stric9r/Line6-FBV3-Clone/Pictures/Drilling1.jpg

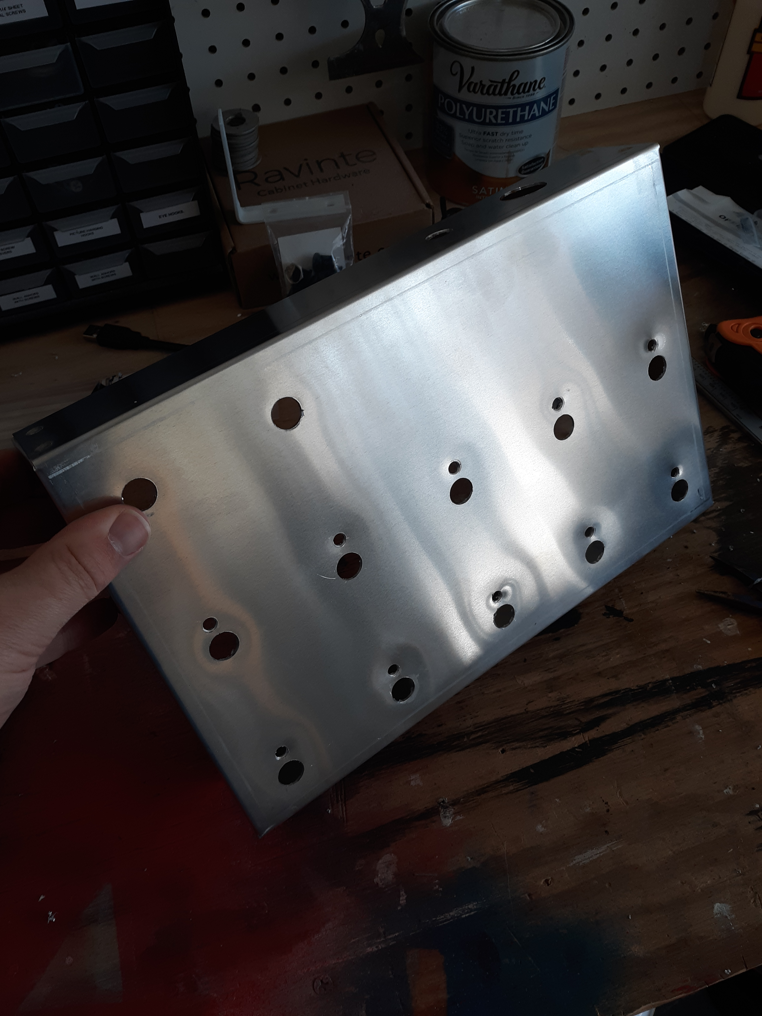
Pictures/Drilling1.jpg
