stric9r/Line6-FBV3-Clone/Pictures/Sanding.jpg

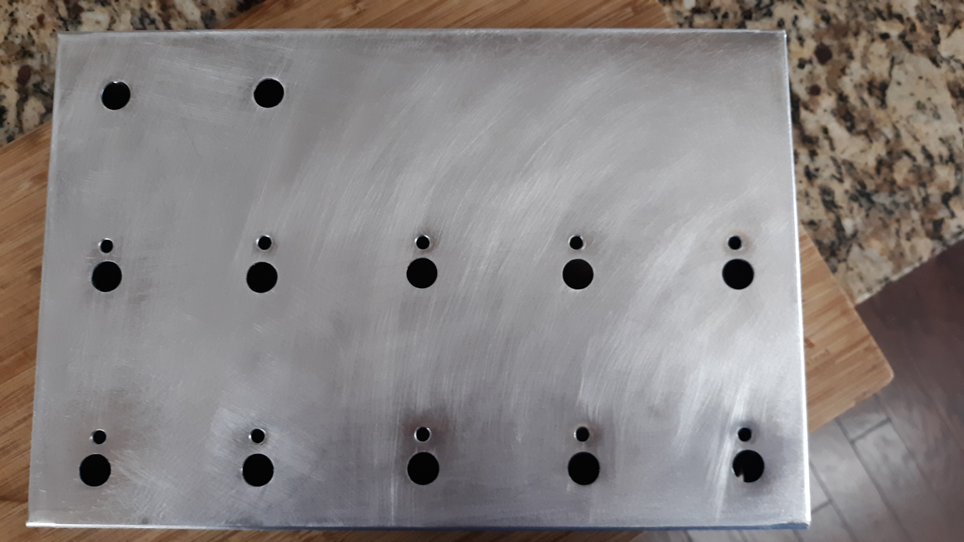
Pictures/Sanding.jpg
