stric9r/Line6-FBV3-Clone/Pictures/ArtBack.jpg

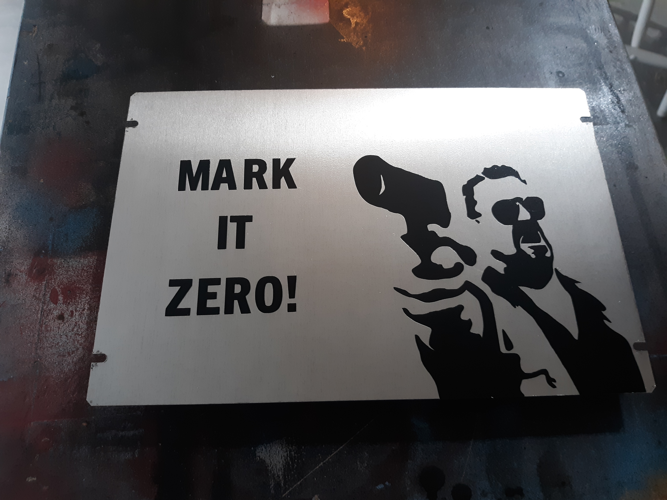
Pictures/ArtBack.jpg
