stric9r/Line6-FBV3-Clone/Pictures/ArtProfile.jpg

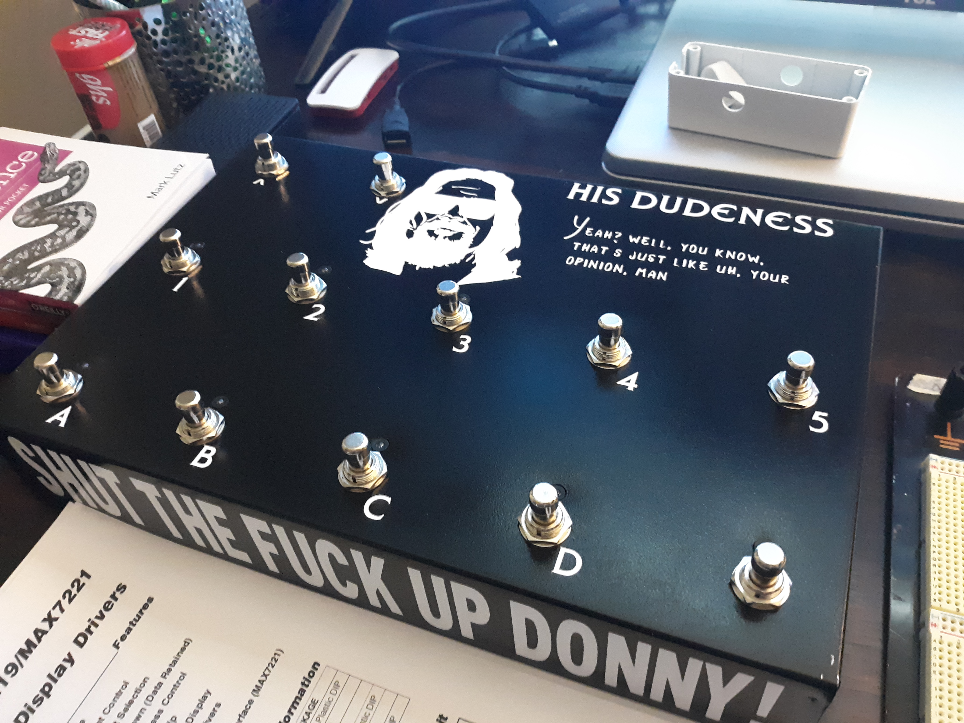
Pictures/ArtProfile.jpg
