stric9r/Line6-FBV3-Clone/Pictures/ArtTop.jpg

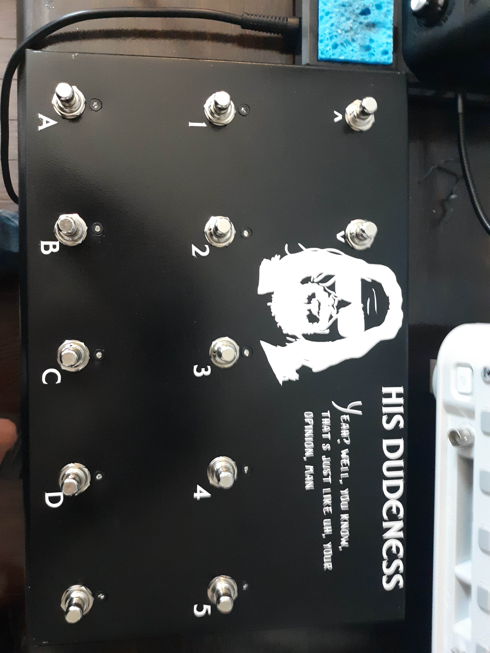
Pictures/ArtTop.jpg
