stric9r/Line6-FBV3-Clone/Pictures/Drilling2.jpg

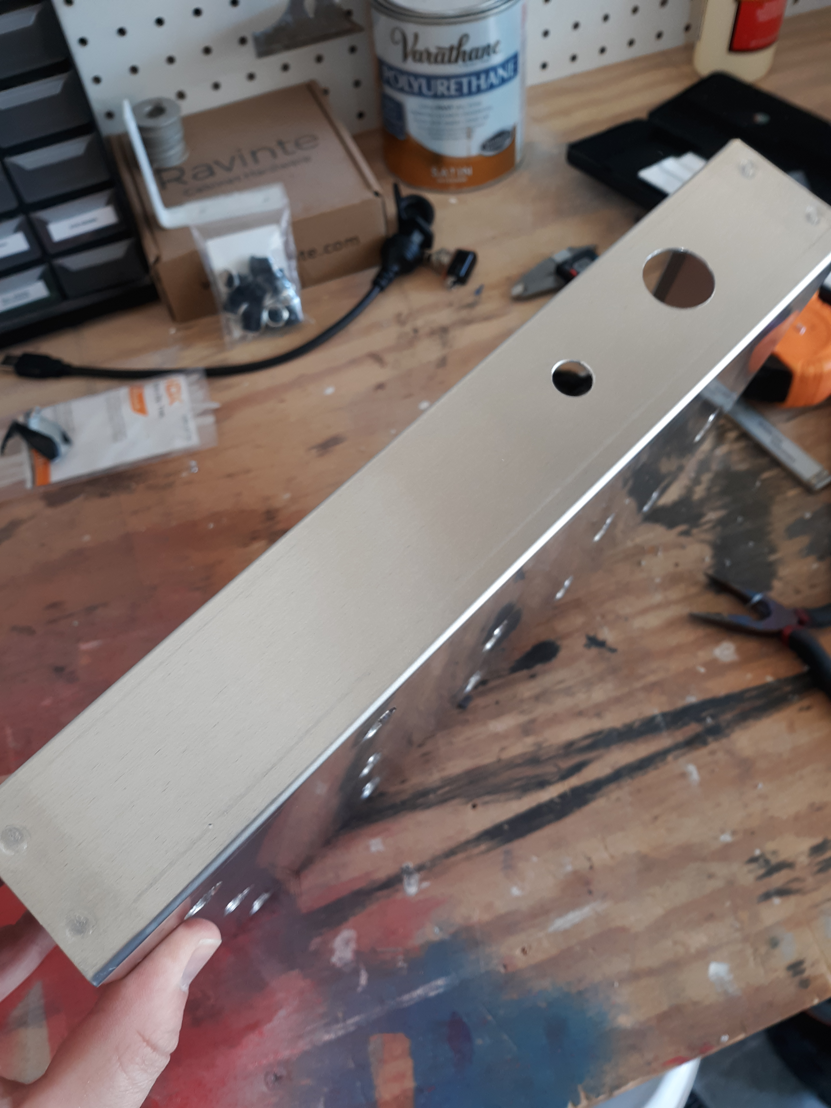
Pictures/Drilling2.jpg
