stric9r/Line6-FBV3-Clone/Pictures/Lights.jpg

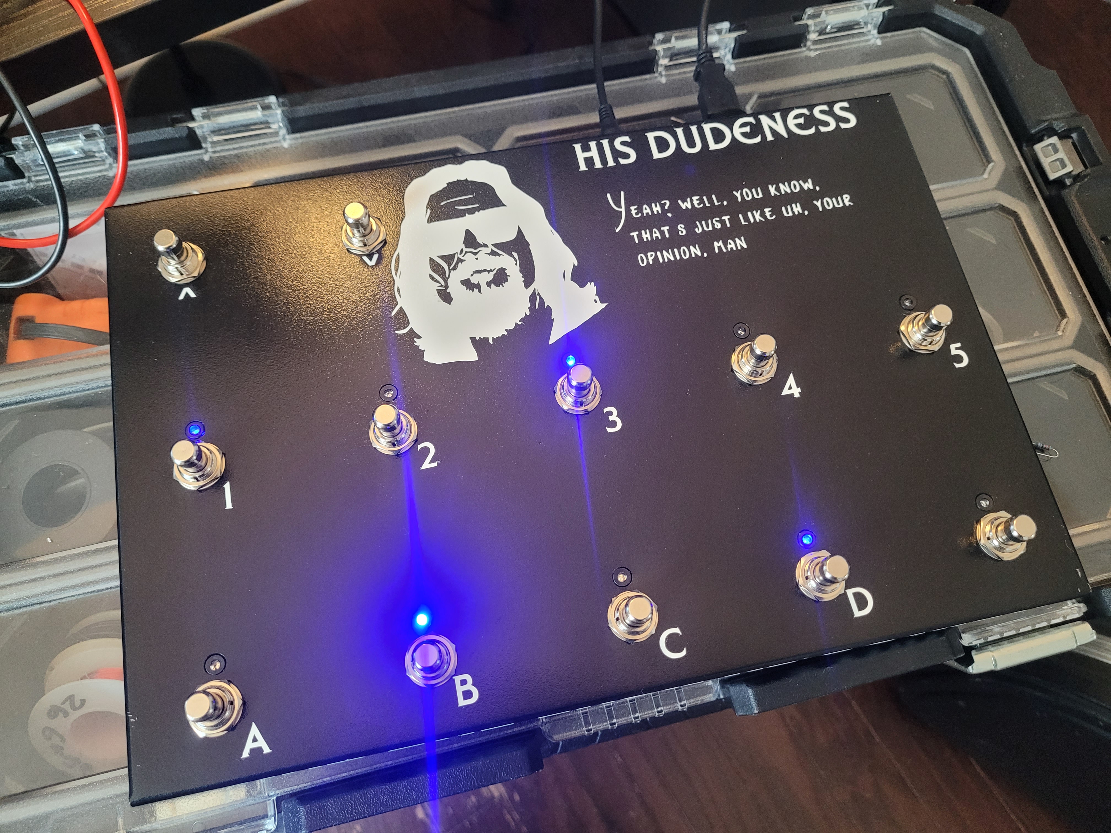
Pictures/Lights.jpg
