stric9r/Line6-FBV3-Clone/Pictures/Paint.jpg

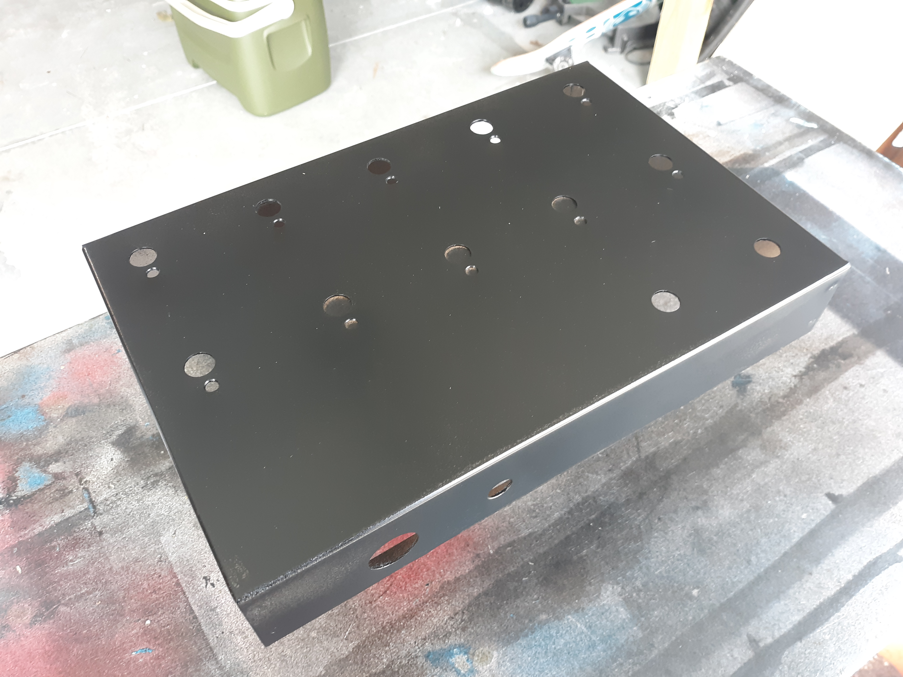
Pictures/Paint.jpg
