stric9r/Line6-FBV3-Clone/(threads)

Thread 1 (2020-12-27):

Decode feedback from amp to get effect on/off status

stric9r, 2020-12-27:

stric9r, 2020-12-27:
Once decoded add the feedback to led's that can show status of the switch

stric9r, 2021-01-09:
When switching presets, a load of data is sent, focus there first.
Also when authenticating, loads more of data is sent (overwhelming amount), look there after the pattern is found in the preset switching.

A hack would be to specify preset X when starting up, to just get the data it needs then.

stric9r, 2021-01-10:
When sending a control packet to turn on/off pedal, there are two packets returned.  Regardless of on/off, they are always the same.  Seems like this is an ACK thing:

INPUT:

0x04 0xf0 0x00 0x01
0x04 0x0c 0x22 0x00
0x04 0x4d 0x00 0x18
0x04 0x00 0x00 0x0b
0x04 0x00 0x01 0x00
0x04 0x00 0x00 0x04
0x04 0x00 0x00 0x00
0x04 0x00 0x00 0x00
0x04 0x00 0x00 0x00
0x06 0x00 0xf7 0x00
received 40
usb result code: SUCCESS

INPUT:

0x04 0xf0 0x00 0x01
0x04 0x0c 0x22 0x00
0x04 0x4d 0x00 0x19
0x04 0x00 0x01 0x07
0x04 0x00 0x03 0x00
0x04 0x00 0x00 0x10
0x04 0x00 0x00 0x03
0x04 0x00 0x02 0x00
0x04 0x00 0x00 0x7f
0x04 0x7f 0x60 0x7f
0x04 0x7f 0x02 0x00
0x04 0x00 0x00 0x01
0x04 0x00 0x00 0x00
0x04 0x00 0x00 0x00
0x07 0x00 0x00 0xf7
received 60
usb result code: SUCCESS

Thread 8 (2021-01-09):

Add on/off for Raspberry Pi

stric9r, 2021-01-09:
Add a switch or button to shut down and startup the raspberry pi properly

stric9r, 2021-03-28:
Add shutdown command based on if the TBD is held down.
Long term, Add a switch on back of HW to that shorts the run pins together to start up again.  But SW solution would be to just cycle power.

stric9r, 2021-03-31:
Just call
```
// Running Linux OS command using system
system("shutdown -P now");
```

It's a one off project, and it's not going to be ported to any OS.

Thread 9 (2021-01-10):

Improve response time

stric9r, 2021-01-10:
Right now, there seems to be a second delay for every button press.  If you press 3 buttons at the same time, each command is sent with a second delay (that's 3 seconds!).

Shorten that time frame. Look at changing timeouts first.
#define L6_TIMEOUT_OUT      2000 /// ms
#define L6_TIMEOUT_IN       250  /// ms

Right now the usb commands are implemented using simple synchronous model.  Might have to move to asynchronous model to improve response time, assuming fiddling with timeouts don't work.

Closed 2021-01-10.

Thread 15 (2021-01-12):

Implement banks

stric9r, 2021-01-12:
Right now the bank buttons only iterate through presets.  Find a way to store banks, and move through them, look at the manual for it.

stric9r, 2021-01-12:
There should be 32 banks, which is preset 1A, 2A, 3A...32A.
So bank switching just changes to preset.
There are 4 other switches that switch presets in that bank A, B, C, D.

So just use the preset command to force bank changes 0, 4, 8..all the way to max banks.
And make 4 more buttons that are labeled A,B,C,D to to increment current bank by 0, 1, 2, 3

stric9r, 2021-01-16:
Went with binary file instead of parsing strings.

Closed 2021-01-16.

Thread 23 (2021-01-24):

Make led MUX driver (CD74HC4067)

stric9r, 2021-01-24:

stric9r, 2021-01-24:
https://www.sparkfun.com/products/9056

stric9r, 2021-01-24:
No good.  After some experimenting, it looks like there is some leakage current on the un-selected pins.
Probably need to use a shift register instead.

Closed 2021-01-24.

Thread 36 (2021-12-23):

Address HW bug in MAX7219

stric9r, 2021-12-23:
Right now the current limiting resistor is 22k.  It should be closer to 10 or 14k.

This issue causes the chip to crash when too many LED's come on.
