stric9r/Line6-FBV3-Clone/Hardware/L6-FBV3-Clone/L6-FBV3-Clone.kicad_pcb

## KiCad design Q1-Keys.sch

Schematic: Q1-Keys.sch

Parts:
ND0, ND1, ND2, ND3, ND4, ND5, ND6, ND7, ND8, ND9, ND10, ND11, ND12, ND13, ND14, ND15, ND16, ND17, ND18, ND19, ND20, ND21, ND22, ND23, ND24, ND25, ND26, ND27, ND28, ND29, ND30, ND31, ND32, ND33, ND34, ND35, ND36, ND37, ND38, ND39, ND40, ND41, ND42, ND43, ND44, ND45, ND46, ND47, ND48, ND49, ND50, ND51, ND52, ND53, ND54, ND55, ND56, ND57, ND58, ND59, ND60, ND61, ND62, ND63, ND64, ND65, ND66, ND67, ND68, ND69, ND70, ND71, ND72, ND73, ND74, ND75, ND76, ND77, ND78, ND79, ND80, ND81, ND82: D
SW1, SW2, SW3, SW4, SW5, SW6, SW7, SW8, SW9, SW10, SW11, SW12, SW13, SW14, SW16, SW17, SW18, SW19, SW20, SW21, SW22, SW23, SW24, SW25, SW26, SW27, SW28, SW29, SW30, SW31, SW32, SW33, SW34, SW35, SW36, SW37, SW38, SW39, SW40, SW41, SW42, SW43, SW44, SW45, SW46, SW47, SW48, SW49, SW50, SW51, SW52, SW53, SW54, SW55, SW56, SW57, SW58, SW59, SW60, SW61, SW62, SW63, SW64, SW65, SW66, SW67, SW68, SW69, SW70, SW71, SW72, SW73, SW74, SW75, SW76, SW77, SW78, SW79, SW80, SW81, SW82: SW_Push
SW15: Rotary_Encoder_Switch
