stric9r/Line6-FBV3-Clone/Hardware/L6-FBV3-Clone/L6-FBV3-Clone.kicad_pcb

## KiCad design Q1.sch

Schematic: Q1.sch

Parts:
BOOT0: RESET
JP2: Conn_01x07_Shielded
R3, R4: R
TX: TestPoint
U6: STM32L432KBU6; QFN-32-1EP_5x5mm_P0.5mm_EP3.45x3.45mm
U7: 74HC595

Notes on the sheet:
USART1_TX
SPI1_MOSI
SPI1_NSS
