stric9r/Line6-FBV3-Clone/(commit log)

2020-12-27 Update main.c
    Fixed typo in comment
    [main.c]
2020-12-27 Added basic framework for bank changing, but still not working. Need to do more research - this is a backup.
    [main.c]
2020-12-27 Updated HELLO to be COMMAND 1
    [Line6_Spider_V_USB_Protocol.xlsx]
2021-01-09 Changed pinout of inputs to do debugging. Added string descriptions of effects for printfs.
2021-01-09 Updated documentation for bank up/down information
    [Line6_Spider_V_USB_Protocol.xlsx]
2021-01-11 Added stdint, trying to fix some build updates
    [fbv3.c, fbv3.h, fbv3_store.c, main.c]
2021-01-12 Still problematic, not reading whole file in buffer, backup only
    [fbv3.c, fbv3_store.c, main.c]
2021-01-17 Debug print cleanup
2021-03-26 Adding HW, but untested and not coded. Just a place saver for now.
    [L6-FBV3-Clone.kicad_pcb, L6-FBV3-Clone.sch]
2021-03-26 Moving to single HW folder, untested schematic, no code for it yet
    [L6-FBV3-Clone.kicad_pcb, L6-FBV3-Clone.sch]
2021-03-28 Fix some compile errors
    [main.c, max7219.c, max7219.h]
2021-03-28 Updated README and try to fix more build errors
    [max7219.c]
2021-03-28 more build error fixes
    [max7219.c]
2021-03-28 More build errors fixed
    [max7219.c]
2021-03-28 Fix build errors, testing with issues to resolve, backup
    [main.c, max7219.c, max7219.h]
2021-04-01 Code added but not really tested, close enough to push through till pin's assigned more permanent
2021-04-17 FIrst pass of pin assignments, also added ALT_PIN
2021-04-17 Updated schematic
    [L6-FBV3-Clone.sch]
2021-04-17 Fix error in schematic
    [L6-FBV3-Clone.sch]
2021-04-18 Fixed schematic rule check, assigned components
    [L6-FBV3-Clone.sch]
2021-12-19 Back up still debugging LED io
2021-12-23 Fix to LED assignments
    LED HW bug present, needs lower value limiting resistor
    [L6-FBV3-Clone.sch]
