stric9r/Line6-FBV3-Clone/Pictures/RatsNest1.jpg

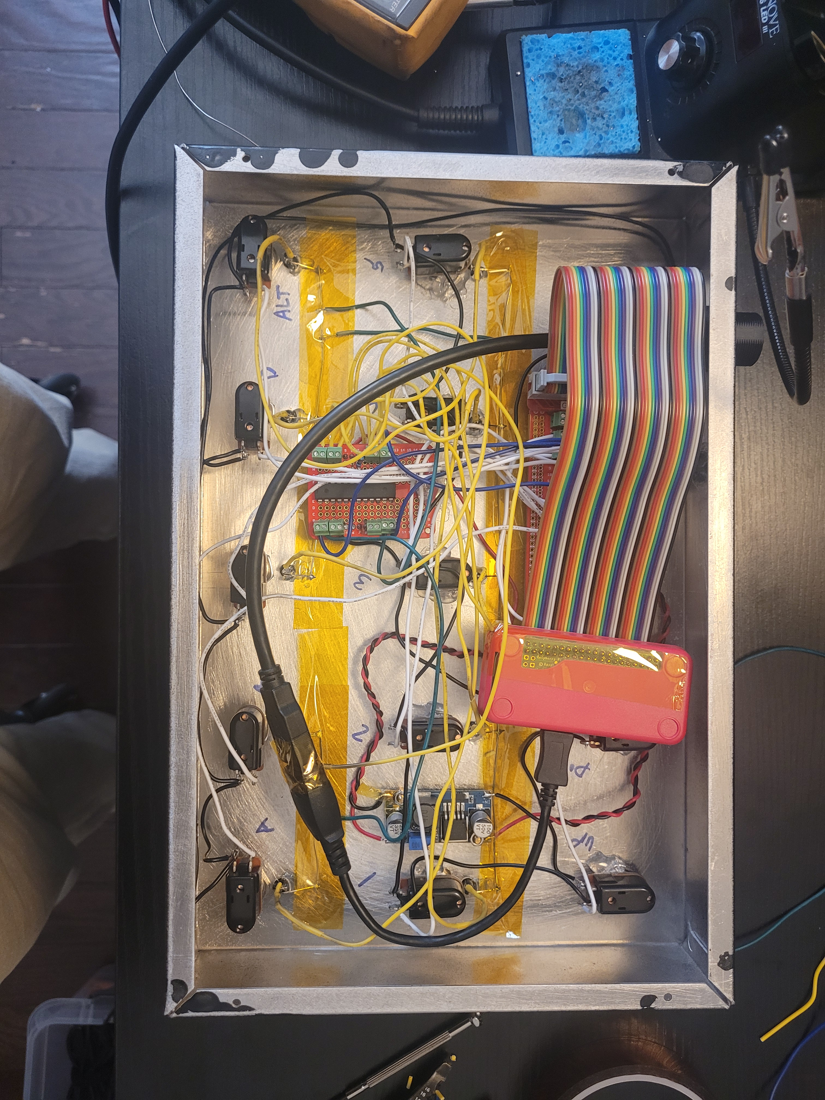
Pictures/RatsNest1.jpg
