stric9r/Line6-FBV3-Clone/Pictures/RatsNest2.jpg

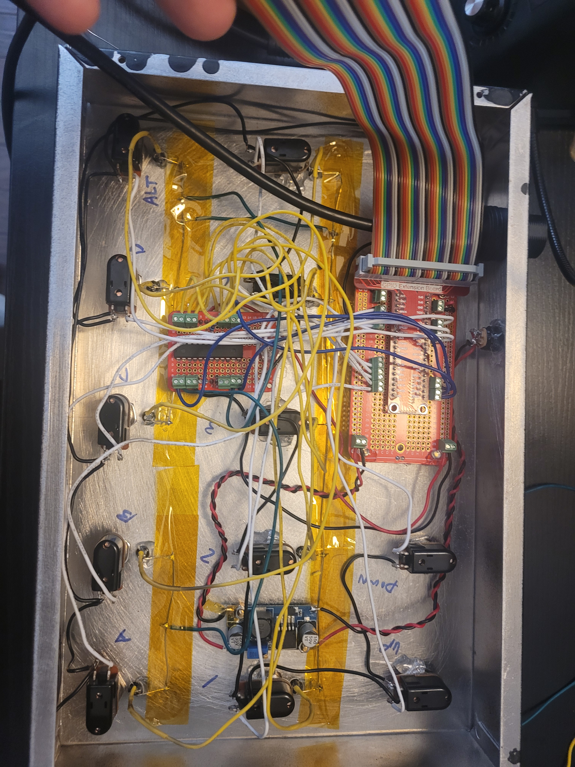
Pictures/RatsNest2.jpg
